sprakashb/Si5351VFO-BFO-with-Keypad/fullSmall.png

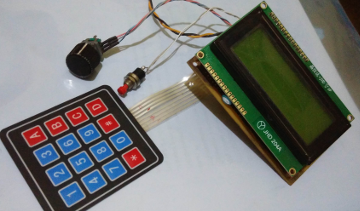
fullSmall.png
