sprakashb/Si5351VFO-BFO-with-Keypad/README.md

# Si5351VFO-BFO-with-Keypad-
Si5351 based VFO / BFO with 4 line display, Keypad and Rotary encoder.

Some pics on vu2spf.blogspot.in

Ver 1.1 :Aug 2016

Ver 1.2 : 26 Sep 2016 : minor mods in band switching
