sprakashb/Si5351VFO-BFO-with-Keypad/Si5351DDS.pdf

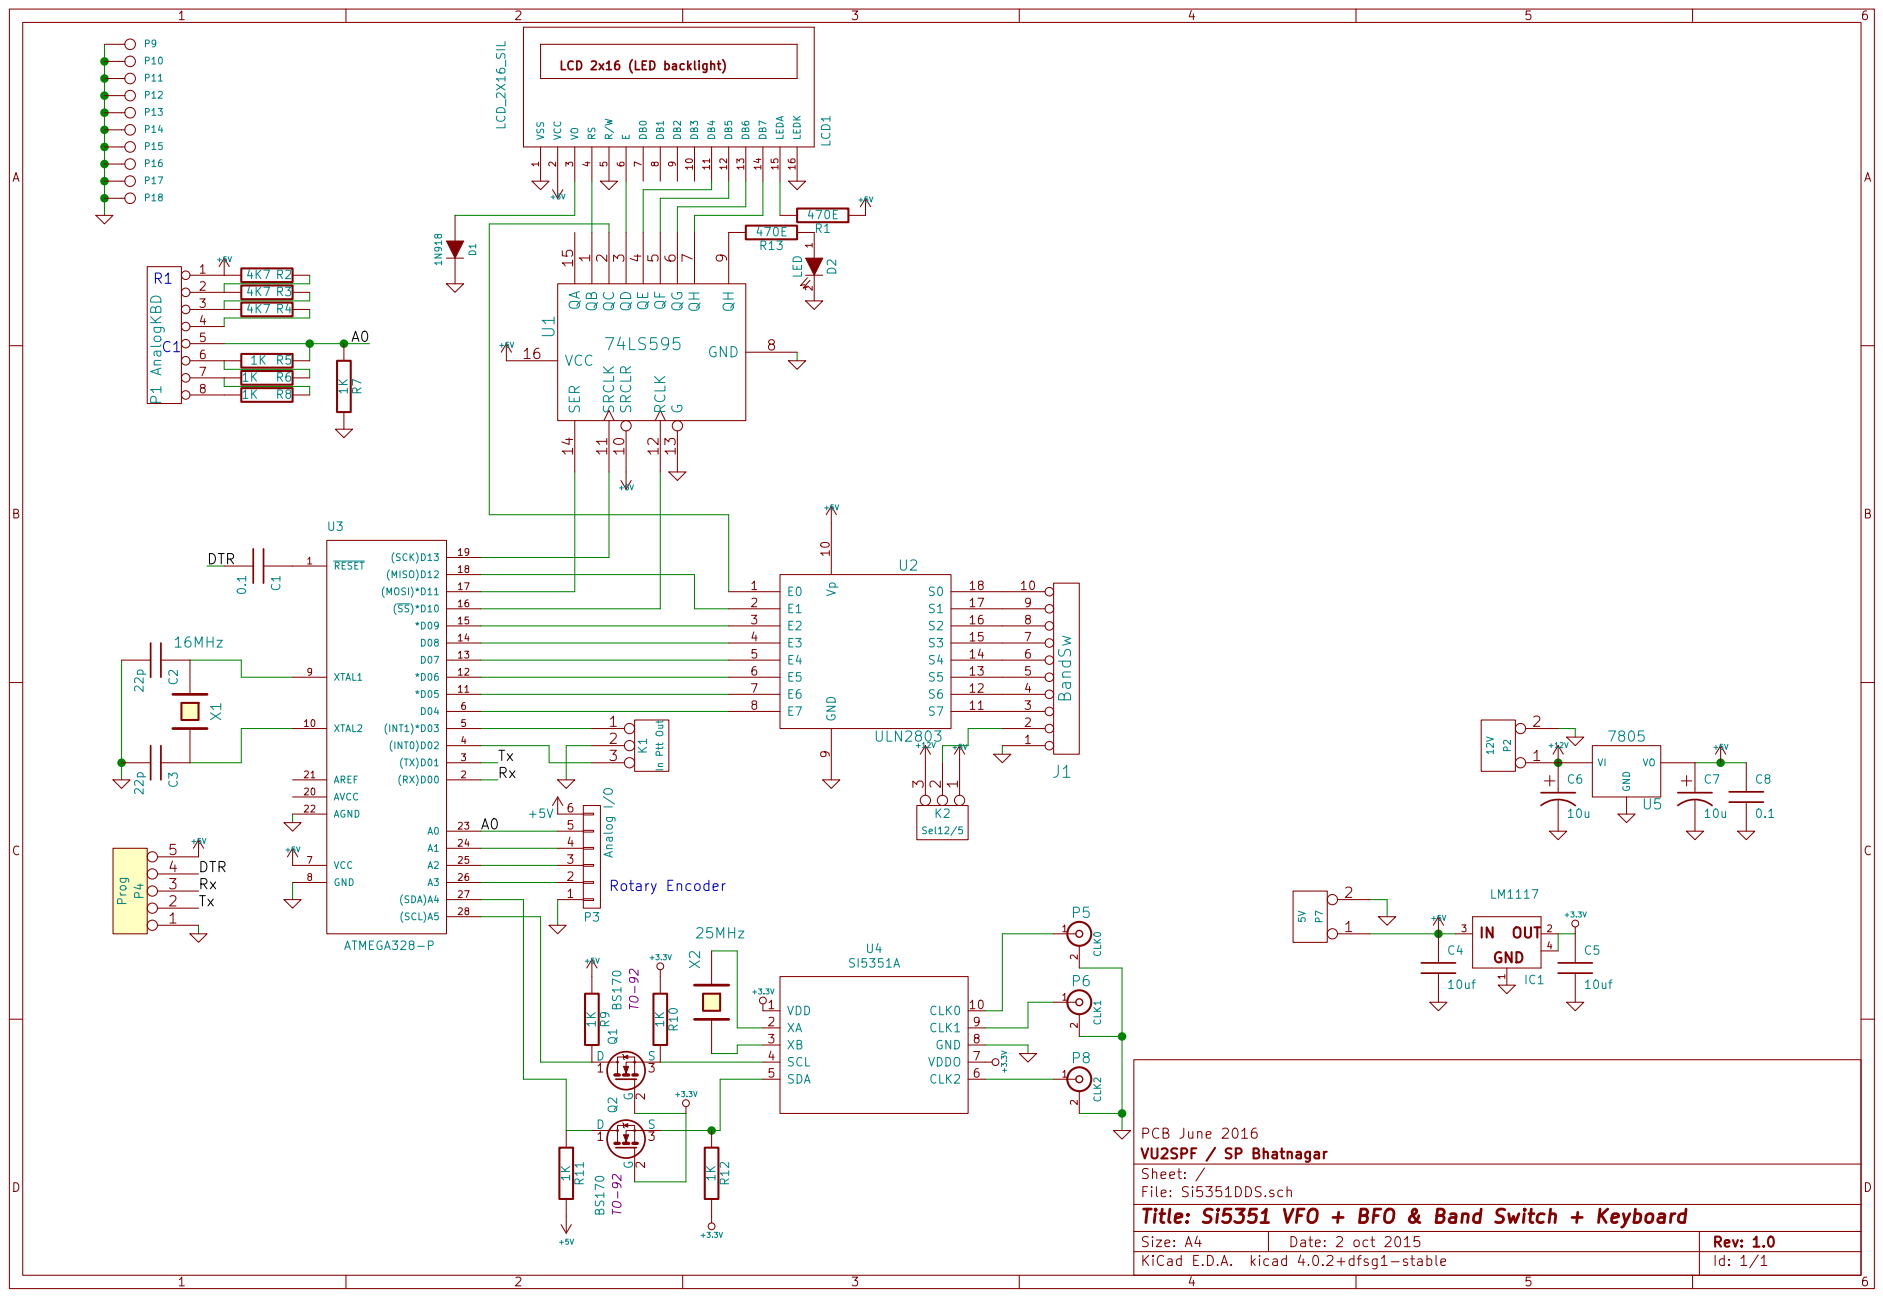
[picture p2: page 1]

File: Si5351DDS.sch Sheet: / VU2SPF / SP Bhatnagar PCB June 2016

Id: 1/1 Title: Si5351 VFO + BFO & Band Switch + Keyboard
