sprakashb/Si5351VFO-BFO-with-Keypad/Si5351DDS-Back.pdf

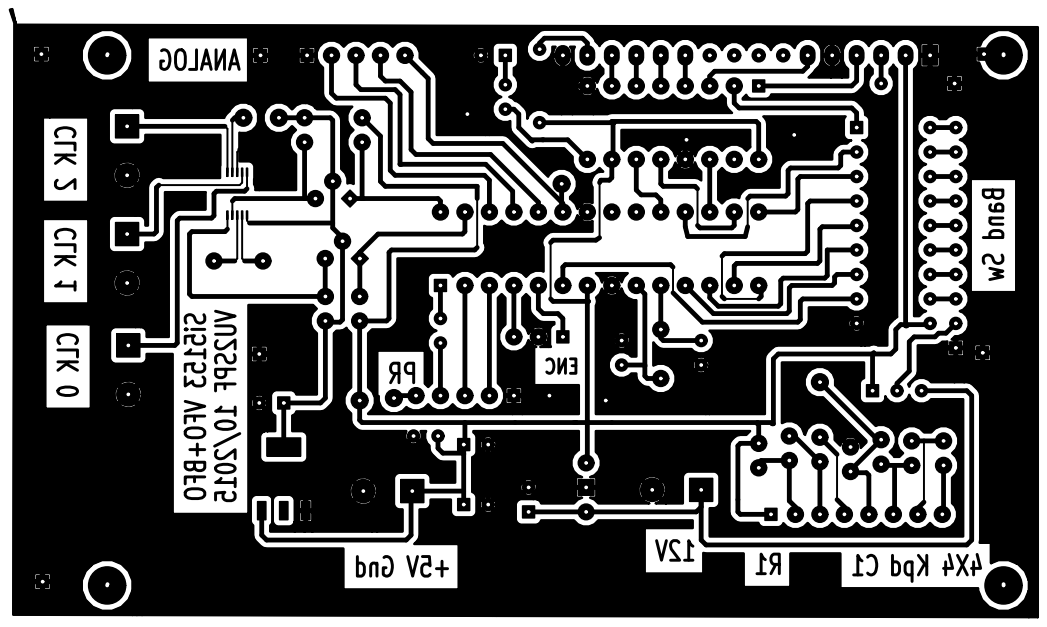
[picture p3: page 1]
