sprakashb/Si5351VFO-BFO-with-Keypad/(commit log)

2016-09-16 Circuit diagram
2016-09-16 PCB Layout
